TomasD-git/Smart-watch/production/LCSC_BOM.xls

bom.csv |  |  |  |  |  |  |  |  |  | LCSC BOM Quotation
 |  |  |  |  |  |  |  |  |  | BOM Date Created：30/08/26 02:53:16 |  |  |  | BOM Export Date: 30/08/26 02:58:51 |  |  |  | The matching result is a real-time query result, availability and prices may fluctuate. Backorder items are estimated prices for your reference, please submit "Create Quote" to get the real price. All information is provided "as is" and is subject to change without notice. Any use made of the information provided is without recourse to LCSC and at the user's risk.
 |  |  |  |  |  |  |  |  |  | EST TOTAL :$44.15 |  |  |  | Website：https://www.lcsc.com/bom | https://www.lcsc.com/bom | https://www.lcsc.com/bom | https://www.lcsc.com/bom
Uploaded data |  |  |  |  |  |  |  |  |  | LCSC Matching Results
LCSC# | Mfr. | Mrf# | Description | Package | Value | Customer Part Number | Quantity | Target Price(USD) | Target Lead Time(Business Days) | Mrf# | Mfr. | Order Qty. | Unit Price(USD) | Ext.Price(USD) | LCSC# | Package | Min | Mult | SPQ | Availability | Stock Status | Customer Notes | Description | Matched status | Product Link
 |  |  |  |  |  | - | 2 |  |  | - | - | - | - | - | - | - | - | - | - | - | - |  | - | No Matches Found | https://uat.lcsc.com/product-detail/schottky-barrier-diodes-sbd_lge-10mq040n_C688893.html
C89334 |  |  | 2450AT18A100E | ANT-SMD_L3.2-W1.6 |  | - | 1 |  |  | 2450AT18A100E | Johanson Dielectrics | 1 | 1.0289 | 1.03 | C89334 | 1206 | 1 | 1 | 3000 | 7205 | In Stock |  | RF ANTENNA 2.4G Surface Mount 1206 | Exact Matches | https://www.lcsc.com/product-detail/C89334.html
C60474 |  |  | 100nF | 402 |  | - | 100 |  |  | CC0402KRX7R7BB104 | YAGEO | 100 | 0.0054 | 0.54 | C60474 | 0402 | 100 | 100 | 10000 | 11937500 | In Stock |  | 100nF ±10% 16V Ceramic Capacitor X7R 0402 | Exact Matches | https://www.lcsc.com/product-detail/C60474.html
C52923 |  |  | 1uF | 402 |  | - | 50 |  |  | CL05A105KA5NQNC | Samsung Electro-Mechanics | 50 | 0.0122 | 0.61 | C52923 | 0402 | 50 | 50 | 10000 | 3301650 | In Stock |  | 1uF ±10% 25V Ceramic Capacitor X5R 0402 | Exact Matches | https://www.lcsc.com/product-detail/C52923.html
C309455 |  |  | 1pF | 402 |  | - | 100 |  |  | CC0402BRNPO9BN1R0 | YAGEO | 100 | 0.0061 | 0.61 | C309455 | 0402 | 100 | 100 | 10000 | 1296500 | In Stock |  | 1pF 50V Ceramic Capacitor NP0 0402 | Exact Matches | https://www.lcsc.com/product-detail/C309455.html
C76899 |  |  | 1.2pF | 402 |  | - | 20 |  |  | GJM1555C1H1R2WB01D | muRata | 20 | 0.0451 | 0.90 | C76899 | 0402 | 20 | 20 | 10000 | 214240 | In Stock |  | 1.2pF 50V Ceramic Capacitor C0G 0402 | Exact Matches | https://www.lcsc.com/product-detail/C76899.html
C19702 |  |  | 10uF | 603 |  | - | 20 |  |  | CL10A106KP8NNNC | Samsung Electro-Mechanics | 20 | 0.0353 | 0.71 | C19702 | 0603 | 20 | 20 | 4000 | 6626660 | In Stock |  | 10uF ±10% 10V Ceramic Capacitor X5R 0603 | Exact Matches | https://www.lcsc.com/product-detail/C19702.html
C272875 |  |  | 47nF | 402 |  | - | 100 |  |  | CC0402KRX7R9BB473 | YAGEO | 100 | 0.0041 | 0.41 | C272875 | 0402 | 100 | 100 | 10000 | 977700 | In Stock |  | 47nF ±10% 50V Ceramic Capacitor X7R 0402 | Exact Matches | https://www.lcsc.com/product-detail/C272875.html
C368809 |  |  | 4.7uF | 402 |  | - | 50 |  |  | CL05A475KP5NRNC | Samsung Electro-Mechanics | 50 | 0.0187 | 0.94 | C368809 | 0402 | 50 | 50 | 10000 | 1266750 | In Stock |  | 4.7uF ±10% 10V Ceramic Capacitor X5R 0402 | Exact Matches | https://www.lcsc.com/product-detail/C368809.html
C19666 |  |  | 4.7uF | 603 |  | - | 10 |  |  | CL10A475KO8NNNC | Samsung Electro-Mechanics | 10 | 0.0337 | 0.34 | C19666 | 0603 | 10 | 10 | 4000 | 1965340 | In Stock |  | 4.7uF ±10% 16V Ceramic Capacitor X5R 0603 | Exact Matches | https://www.lcsc.com/product-detail/C19666.html
C106202 |  |  | 18pF | 402 |  | - | 100 |  |  | CC0402JRNPO9BN180 | YAGEO | 100 | 0.0062 | 0.62 | C106202 | 0402 | 100 | 100 | 10000 | 1159600 | In Stock |  | 18pF ±5% 50V Ceramic Capacitor NP0 0402 | Exact Matches | https://www.lcsc.com/product-detail/C106202.html
C106201 |  |  | 12pF | 402 |  | - | 100 |  |  | CC0402JRNPO9BN120 | YAGEO | 100 | 0.0038 | 0.38 | C106201 | 0402 | 100 | 100 | 10000 | 2052800 | In Stock |  | 12pF ±5% 50V Ceramic Capacitor NP0 0402 | Exact Matches | https://www.lcsc.com/product-detail/C106201.html
C77177 |  |  | 100pF | 402 |  | - | 50 |  |  | GRM1555C1H101JA01D | muRata | 50 | 0.0109 | 0.55 | C77177 | 0402 | 50 | 50 | 10000 | 974400 | In Stock |  | 100pF ±5% 50V Ceramic Capacitor C0G 0402 | Exact Matches | https://www.lcsc.com/product-detail/C77177.html
C107031 |  |  | 820pF | 402 |  | - | 100 |  |  | CC0402KRX7R9BB821 | YAGEO | 100 | 0.0067 | 0.67 | C107031 | 0402 | 100 | 100 | 10000 | 318400 | In Stock |  | 820pF ±10% 50V Ceramic Capacitor X7R 0402 | Exact Matches | https://www.lcsc.com/product-detail/C107031.html
C82046 |  |  | MBR0530T1G | SOD-123_L2.7-W1.6-LS3.7-RD-1 |  | - | 10 |  |  | MBR0530T1G | onsemi | 10 | 0.0685 | 0.69 | C82046 | SOD-123 | 10 | 10 | 3000 | 94330 | In Stock |  | Diode 30V 500mA Surface Mount SOD-123 | Exact Matches | https://www.lcsc.com/product-detail/C82046.html
C262643 |  |  | AFC07-S24ECA-00 | FPC-SMD_AFC07-S24ECA-00 |  | - | 5 |  |  | AFC07-S24ECA-00 | JUSHUO | 5 | 0.1327 | 0.66 | C262643 | SMD,P=0.5mm,Surface Mount,Right Angle | 5 | 5 | 2000 | 45965 | In Stock |  | FFC/FPC Connector 24 Position 0.5mm Pitch Top Contact Surface Mount, Right Angle | Exact Matches | https://www.lcsc.com/product-detail/C262643.html
 |  |  | Conn_01x03 | PinHeader_1x03_P2.54mm_Vertical |  | - | 1 |  |  | - | - | - | - | - | - | - | - | - | - | - | - |  | - | No Matches Found
 |  |  | Conn_01x05 | PinHeader_1x05_P2.54mm_Vertical |  | - | 1 |  |  | - | - | - | - | - | - | - | - | - | - | - | - |  | - | No Matches Found
C88173 |  |  | 10uH | 805 |  | - | 10 |  |  | MLZ2012M100WT000 | TDK | 10 | 0.0629 | 0.63 | C88173 | 0805 | 10 | 10 | 2000 | 76070 | In Stock |  | 350mA 10uH ±20% 150mA 470mΩ Multilayer inductor 0805 Fixed Inductors RoHS | Exact Matches | https://www.lcsc.com/product-detail/C88173.html
C383402 |  |  | 15uH | 805 |  | - | 10 |  |  | MLZ2012M150WT000 | TDK | 10 | 0.0631 | 0.63 | C383402 | 0805 | 10 | 10 | 2000 | 34820 | In Stock |  | 250mA 15uH ±20% 120mA 950mΩ Multilayer inductor 0805 Fixed Inductors RoHS | Exact Matches | https://www.lcsc.com/product-detail/C383402.html
C86065 |  |  | 4.7nH | 402 |  | - | 100 |  |  | LQG15HS4N7S02D | muRata | 100 | 0.0155 | 1.55 | C86065 | 0402 | 100 | 100 | 10000 | 181500 | In Stock |  | 700mA 4.7nH 160mΩ Multilayer inductor 0402 Fixed Inductors RoHS | Exact Matches | https://www.lcsc.com/product-detail/C86065.html
C86061 |  |  | 2.2nH | 402 |  | - | 50 |  |  | LQG15HS2N2S02D | muRata | 50 | 0.0185 | 0.93 | C86061 | 0402 | 50 | 50 | 10000 | 36250 | In Stock |  | 900mA 2.2nH 120mΩ Multilayer inductor 0402 Fixed Inductors RoHS | Exact Matches | https://www.lcsc.com/product-detail/C86061.html
C524993 |  |  | BRL3225T470K | IND-SMD_L3.2-W2.5-BRL3225T100M |  | - | 5 |  |  | BRL3225T470K | Taiyo Yuden | 5 | 0.1333 | 0.67 | C524993 | 1210 | 5 | 5 | 2000 | 4425 | In Stock |  | 390mA 47uH ±10% 420mA 1.2Ω 1210 Fixed Inductors RoHS | Exact Matches | https://www.lcsc.com/product-detail/C524993.html
C77108 |  |  | 2.7nH | 402 |  | - | 50 |  |  | LQG15HS2N7S02D | muRata | 50 | 0.0221 | 1.11 | C77108 | 0402 | 50 | 50 | 10000 | 182600 | In Stock |  | 800mA 2.7nH 150mΩ Multilayer inductor 0402 Fixed Inductors RoHS | Exact Matches | https://www.lcsc.com/product-detail/C77108.html
C77109 |  |  | 3.9nH | 402 |  | - | 50 |  |  | LQG15HS3N9S02D | muRata | 50 | 0.0177 | 0.89 | C77109 | 0402 | 50 | 50 | 10000 | 100350 | In Stock |  | 750mA 3.9nH 180mΩ Multilayer inductor 0402 Fixed Inductors RoHS | Exact Matches | https://www.lcsc.com/product-detail/C77109.html
C347475 |  |  | AO3400A_C347475 | SOT-23-3_L2.9-W1.3-P1.90-LS2.4-BR |  | - | 20 |  |  | AO3400A | UMW | 20 | 0.0372 | 0.74 | C347475 | SOT-23 | 20 | 20 | 3000 | 1220380 | In Stock |  | N-Channel 30V 5.8A 1.4W Surface Mount SOT-23 | Exact Matches | https://www.lcsc.com/product-detail/C347475.html
C25803 |  |  | 100k | 603 |  | - | 100 |  |  | 0603WAF1003T5E | UNI-ROYAL | 100 | 0.0042 | 0.42 | C25803 | 0603 | 100 | 100 | 5000 | 15234400 | In Stock |  | 100kΩ ±1% 100mW 0603 Thick Film Resistor | Exact Matches | https://www.lcsc.com/product-detail/C25803.html
C98220 |  |  | 10k | 603 |  | - | 100 |  |  | RC0603FR-0710KL | YAGEO | 100 | 0.0040 | 0.40 | C98220 | 0603 | 100 | 100 | 5000 | 11908900 | In Stock |  | 100mW 10kΩ 75V Thick Film Resistor ±100ppm/℃ ±1% 0603 Chip Resistor - Surface Mount RoHS | Exact Matches | https://www.lcsc.com/product-detail/C98220.html
C2907044 |  |  | 5.1k | 603 |  | - | 100 |  |  | FRC0603F5101TS | FOJAN | 100 | 0.0021 | 0.21 | C2907044 | 0603 | 100 | 100 | 5000 | 7175900 | In Stock |  | 5.1kΩ ±1% 100mW 0603 Thick Film Resistor | Exact Matches | https://www.lcsc.com/product-detail/C2907044.html
C2907166 |  |  | 4.7k | 603 |  | - | 100 |  |  | FRC0603J472 TS | FOJAN | 100 | 0.0022 | 0.22 | C2907166 | 0603 | 100 | 100 | 5000 | 8569000 | In Stock |  | 4.7kΩ ±5% 100mW 0603 Thick Film Resistor | Exact Matches | https://www.lcsc.com/product-detail/C2907166.html
C2907005 |  |  | 2.2k | 603 |  | - | 100 |  |  | FRC0603F2201TS | FOJAN | 100 | 0.0022 | 0.22 | C2907005 | 0603 | 100 | 100 | 5000 | 5079800 | In Stock |  | 2.2kΩ ±1% 100mW 0603 Thick Film Resistor | Exact Matches | https://www.lcsc.com/product-detail/C2907005.html
C2930150 |  |  | 3 | 603 |  | - | 100 |  |  | FRC0603F3R00TS | FOJAN | 100 | 0.0028 | 0.28 | C2930150 | 0603 | 100 | 100 | 5000 | 125500 | In Stock |  | 3Ω ±1% 100mW 0603 Thick Film Resistor | Exact Matches | https://www.lcsc.com/product-detail/C2930150.html
C2907003 |  |  | FRC0603F1004TS | R0603 |  | - | 100 |  |  | FRC0603F1004TS | FOJAN | 100 | 0.0023 | 0.23 | C2907003 | 0603 | 100 | 100 | 5000 | 6053400 | In Stock |  | 1MΩ ±1% 100mW 0603 Thick Film Resistor | Exact Matches | https://www.lcsc.com/product-detail/C2907003.html
C2906983 |  |  | 10 | 603 |  | - | 100 |  |  | FRC0603F10R0TS | FOJAN | 100 | 0.0025 | 0.25 | C2906983 | 0603 | 100 | 100 | 5000 | 3802200 | In Stock |  | 10Ω ±1% 100mW 0603 Thick Film Resistor | Exact Matches | https://www.lcsc.com/product-detail/C2906983.html
C42420265 |  |  | TS-24CA-S26 | SW-SMD_L4.7-W3.5-P3.35-EH |  | - | 10 |  |  | TS-24CA-S26 | JXTCONN | 10 | 0.0247 | 0.25 | C42420265 | SMD-4P,4.8x2.1mm | 10 | 10 | 3000 | 31070 | In Stock |  | Tactile Switch SPST 260gf SMD (SMT) Tab Surface Mount, Right Angle | Exact Matches | https://www.lcsc.com/product-detail/C42420265.html
C44639442 |  |  | BQ25186DLHR | WSON-10_L2.2-W2.0-P0.40-BL-EP_TI_DLH0010A |  | - | 1 |  |  | BQ25186DLHR | TI | 1 | 2.3108 | 2.31 | C44639442 | WSON-10 | 1 | 1 | 3000 | 1520 | Backordered |  | 3.6V~18V 1 1A WSON-10 Battery Chargers RoHS | Exact Matches | https://www.lcsc.com/product-detail/C44639442.html
C2836813 |  |  | BMI270 | LGA-14_L3.0-W2.5-P0.50-BR |  | - | 1 |  |  | BMI270 | Bosch | 1 | 3.2183 | 3.22 | C2836813 | LGA-14(2.5x3) | 1 | 1 | 5000 | 9433 | In Stock |  | LGA-14(2.5x3) IMUs (Inertial Measurement Units) RoHS | Exact Matches | https://www.lcsc.com/product-detail/C2836813.html
C171681 |  |  | BMM150 | WLCSP-12_L1.6-W1.6_BMM150 |  | - | 1 |  |  | BMM150 | Bosch | 0 | 0.7593 | 0.01 | C171681 | - | 1 | 1 | 10000 | 5402 | In Stock |  | WLCSP-12(1.6x1.6) Linear, Compass (ICs) RoHS | Exact Matches
C3019759 |  |  | RV-3028-C7 32.768KHZ 1PPM TA QC | OSC-SMD_8P-L3.2-W1.5-P0.90-BL |  | - | 1 |  |  | RV-3028-C7-32.768kHz-1ppm-TA-QC | Micro Crystal | 1 | 2.2239 | 2.22 | C3019759 | SMD3215-8P | 1 | 1 | 1000 | 1250 | Backordered |  | Built-in Yes SMD3215-8P Real Time Clocks RoHS | Exact Matches | https://www.lcsc.com/product-detail/C3019759.html
C190794 |  |  | NRF52840-QIAA-R | AQFN-73_L7.0-W7.0-P0.50-BL-EP4.8 |  | - | 1 |  |  | NRF52840-QIAA-R | NORDIC | 1 | 5.8937 | 5.89 | C190794 | AQFN-73-EP(7x7) | 1 | 1 | 3000 | 52163 | In Stock |  | IC RF TXRX Bluetooth ISM IoT LoRa ZigBee 2400MHz~2483.5MHz AQFN-73-EP(7x7) | Exact Matches | https://www.lcsc.com/product-detail/C190794.html
C2682616 |  |  | MAX17048G+T10 | TDFN-8_L2.0-W2.0-P0.50-BL-EP1.2 |  | - | 1 |  |  | MAX17048G+T10 | MAXIM | 1 | 2.1864 | 2.19 | C2682616 | DFN-8-EP(2x2) | 1 | 1 | 10000 | 15395 | In Stock |  | I2C Lithium Battery DFN-8-EP(2x2) Battery Management RoHS | Exact Matches | https://www.lcsc.com/product-detail/C2682616.html
C50275770 |  |  | MD-LRA371-H20 | MIC-SMD_6P-L3.0-W2.3_MD-LRA371-H20 |  | - | 1 |  |  | MD-LRA371-H20 | Gettop | 1 | 0.7680 | 0.77 | C50275770 | SMD | 1 | 1 | 5500 | 5213 | In Stock |  | Omnidirectional -37dB 65dB SMD Microphones | Exact Matches | https://www.lcsc.com/product-detail/C50275770.html
C97522 |  |  | W25Q256JVEIQTR | WSON-8_L8.0-W6.10-P1.27-BL-EP |  | - | 1 |  |  | W25Q256JVEIQ | Winbond | 1 | 4.5589 | 4.56 | C97522 | WSON-8-EP(6x8) | 1 | 1 | 4000 | 12599 | In Stock |  | FLASH - NOR Memory IC 256Mbit SPI 133MHz WSON-8-EP(6x8) | Exact Matches | https://www.lcsc.com/product-detail/C97522.html
C2765186 |  |  | TYPE-C 16PIN 2MD | USB-C-SMD_TYPE-C-16PIN-2MD-073 |  | - | 20 |  |  | TYPE-C 16PIN 2MD(073) | SHOU HAN | 20 | 0.0707 | 1.41 | C2765186 | SMD | 20 | 20 | 1000 | 985460 | In Stock |  | USB-C (USB TYPE-C) Receptacle Connector 16 Position Surface Mount, Right Angle | Exact Matches | https://www.lcsc.com/product-detail/C2765186.html
C2842180 |  |  | FC31M2-32.768-NTLLLDT | CRYSTAL-SMD_L3.2-W1.5-1 |  | - | 5 |  |  | FC31M2-32.768-NTLLLDT | HCI | 5 | 0.2029 | 1.01 | C2842180 | SMD3215-2P | 5 | 5 | 3000 | 5585 | In Stock |  | Crystal 32.768kHz ±20ppm 12.5pF 50kΩ SMD3215-2P | Exact Matches | https://www.lcsc.com/product-detail/C2842180.html
C187794 |  |  | Q22FA12800025 | CRYSTAL-SMD_4P-L2.0-W1.6-BL |  | - | 5 |  |  | Q22FA12800025 | EPSON | 5 | 0.2546 | 1.27 | C187794 | SMD2016-4P | 5 | 5 | 3000 | 11530 | In Stock |  | Crystal 32MHz ±10ppm 8pF 60Ω SMD2016-4P | Exact Matches | https://www.lcsc.com/product-detail/C187794.html
