TomasD-git/Smart-watch/CAD/250mah 3.7V battery.stp

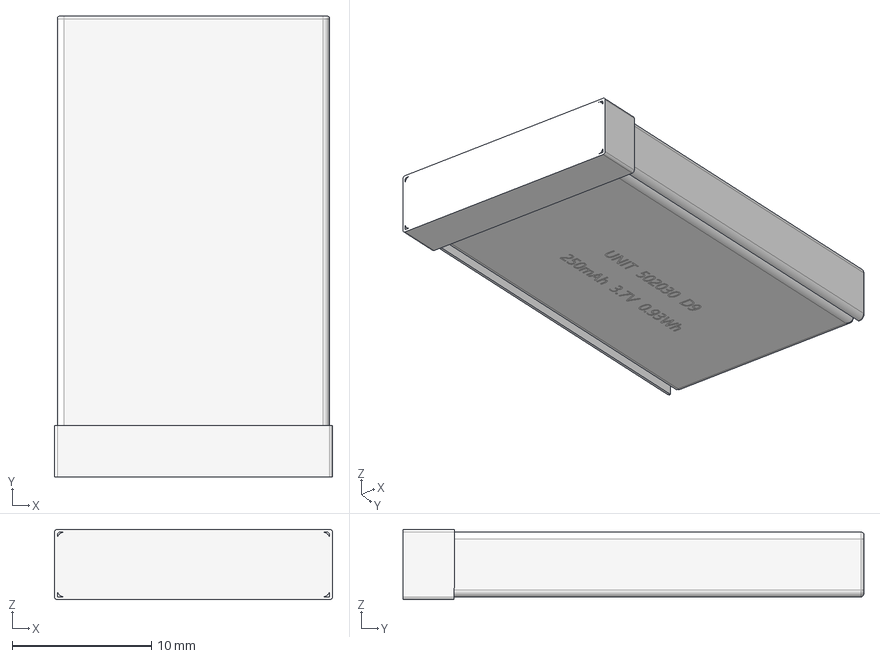
[picture p1: CAD file, 2026-09-03]
CAD/250mah 3.7V battery.stp
20.0 x 33.1 x 5.05 mm
