TomasD-git/Smart-watch/CAD/Smart watch PCB.step

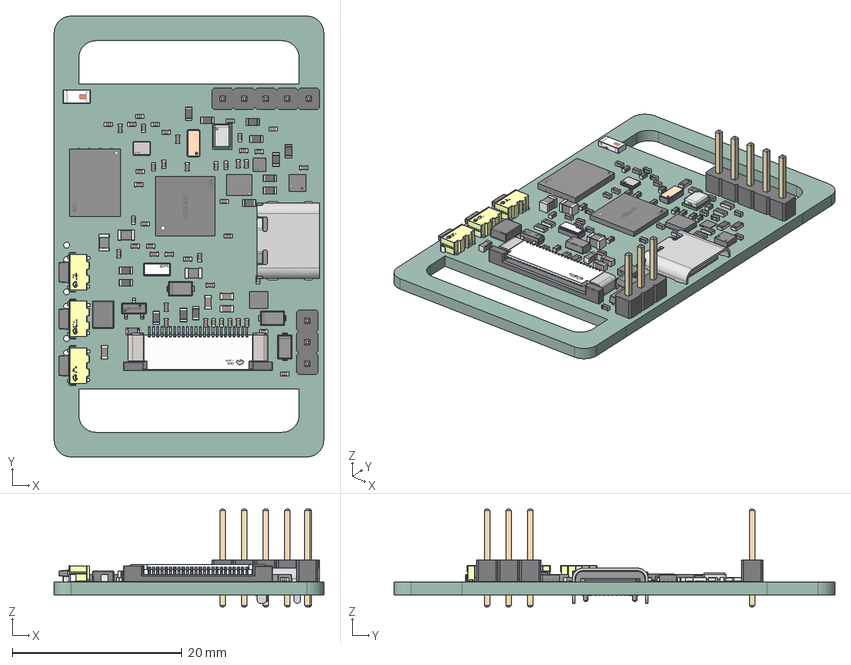
[picture p2: CAD file, 2026-09-03]
CAD/Smart watch PCB.step
31.8 x 52.0 x 11.5 mm
R0603
C_0603_1608Metric x 4
C_0402_1005Metric x 42
R_0603_1608Metric x 14
SOT-23-3P_L2.9-W1.3-H1.0-LS2.4-P0.95
IND-SMD_L3.2-W2.5-BRL3225T100M
L_0805_2012Metric x 3
L_0402_1005Metric x 4
OSC-SMD_8P-L3.2-W1.5-P0.90-BL
CRYSTAL-SMD_4P-L2.0-W1.6-BL
WSON-8_L8.0-W6.0-H0.78-P1.27
SW-SMD_L4.7-W3.5-H1.9-P3.35-EH x 3
PinHeader_1x05_P2.54mm_Vertical
CRYSTAL-SMD_L3.2-W1.5-1
AQFN-73_L7.0-W7.0-H0.9-P0.50
WSON-10_L2.2-W2.0-P0.40-BL-EP_TI_DLH0010A
USB-C-SMD_TYPE-C-6PIN-2MD-073
SOD-123_L2.7-W1.6-LS3.7-RD-1 x 3
TDFN-8_L2.0-W2.0-P0.50-BL-EP1.2
FPC-SMD_AFC07-S24ECA-00
MIC-SMD_6P-L3.0-W2.3_MD-LRA371-H20
WLCSP-12_L1.6-W1.6-H0.6_BMM150
PinHeader_1x03_P2.54mm_Vertical
LGA-14_L3.0-W2.5-P0.50-BR
ANT-SMD_L3.2-W1.6-H1.3
Smart watch_PCB
