TomasD-git/Smart-watch/CAD/1.54 in e-paper 200x200 GDEY0154D67.step

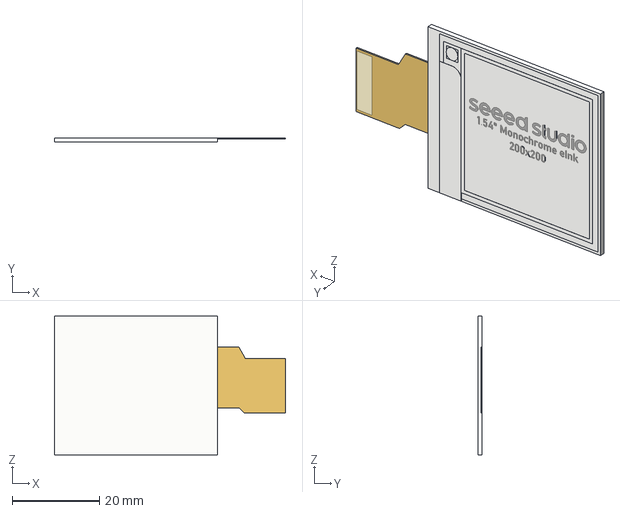
[picture p3: CAD file, 2026-09-03]
CAD/1.54 in e-paper 200x200 GDEY0154D67.step
52.9 x 1.00 x 31.8 mm
