TomasD-git/Smart-watch/CAD/Smart watch NFC Coil PCB.step

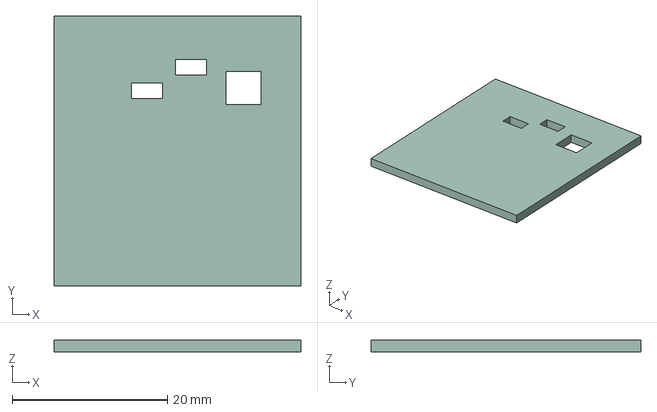
[picture p4: CAD file, 2026-09-03]
CAD/Smart watch NFC Coil PCB.step
31.8 x 34.8 x 1.51 mm
