TomasD-git/Smart-watch/CAD/Top.step

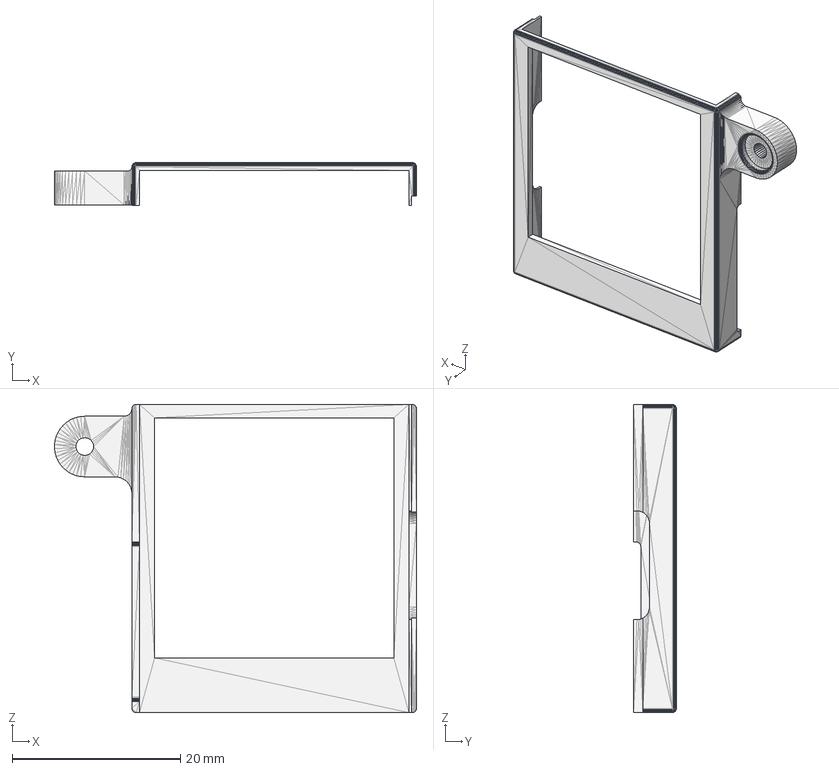
[picture p6: CAD file, 2026-09-03]
CAD/Top.step
43.0 x 5.10 x 36.6 mm
