TomasD-git/Smart-watch/CAD/Bottom.step

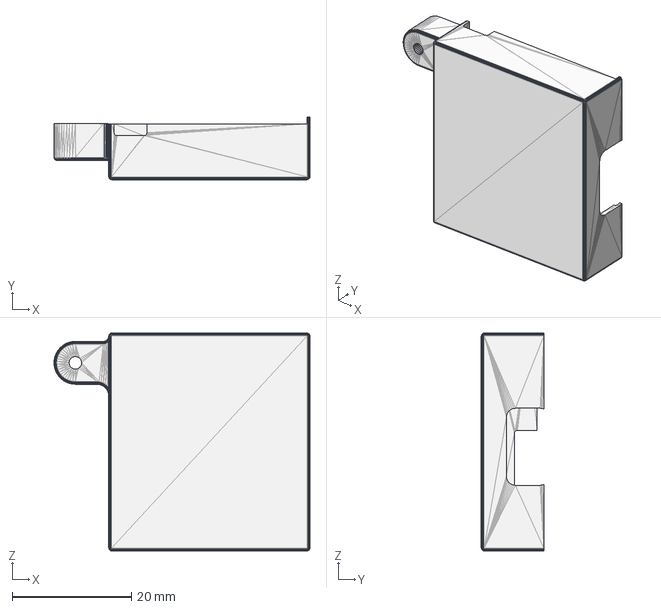
[picture p7: CAD file, 2026-09-03]
CAD/Bottom.step
43.0 x 10.5 x 36.6 mm
