TomasD-git/Smart-watch/(list of files, cad)

Other CAD files:
CAD/Smart Watch source CAD.f3z
