TomasD-git/Smart-watch/Smart Watch/Smart watch/Smart watch.kicad_pcb

## KiCad design Smart Watch/Smart watch/Smart watch.kicad_pcb (2026-09-03)

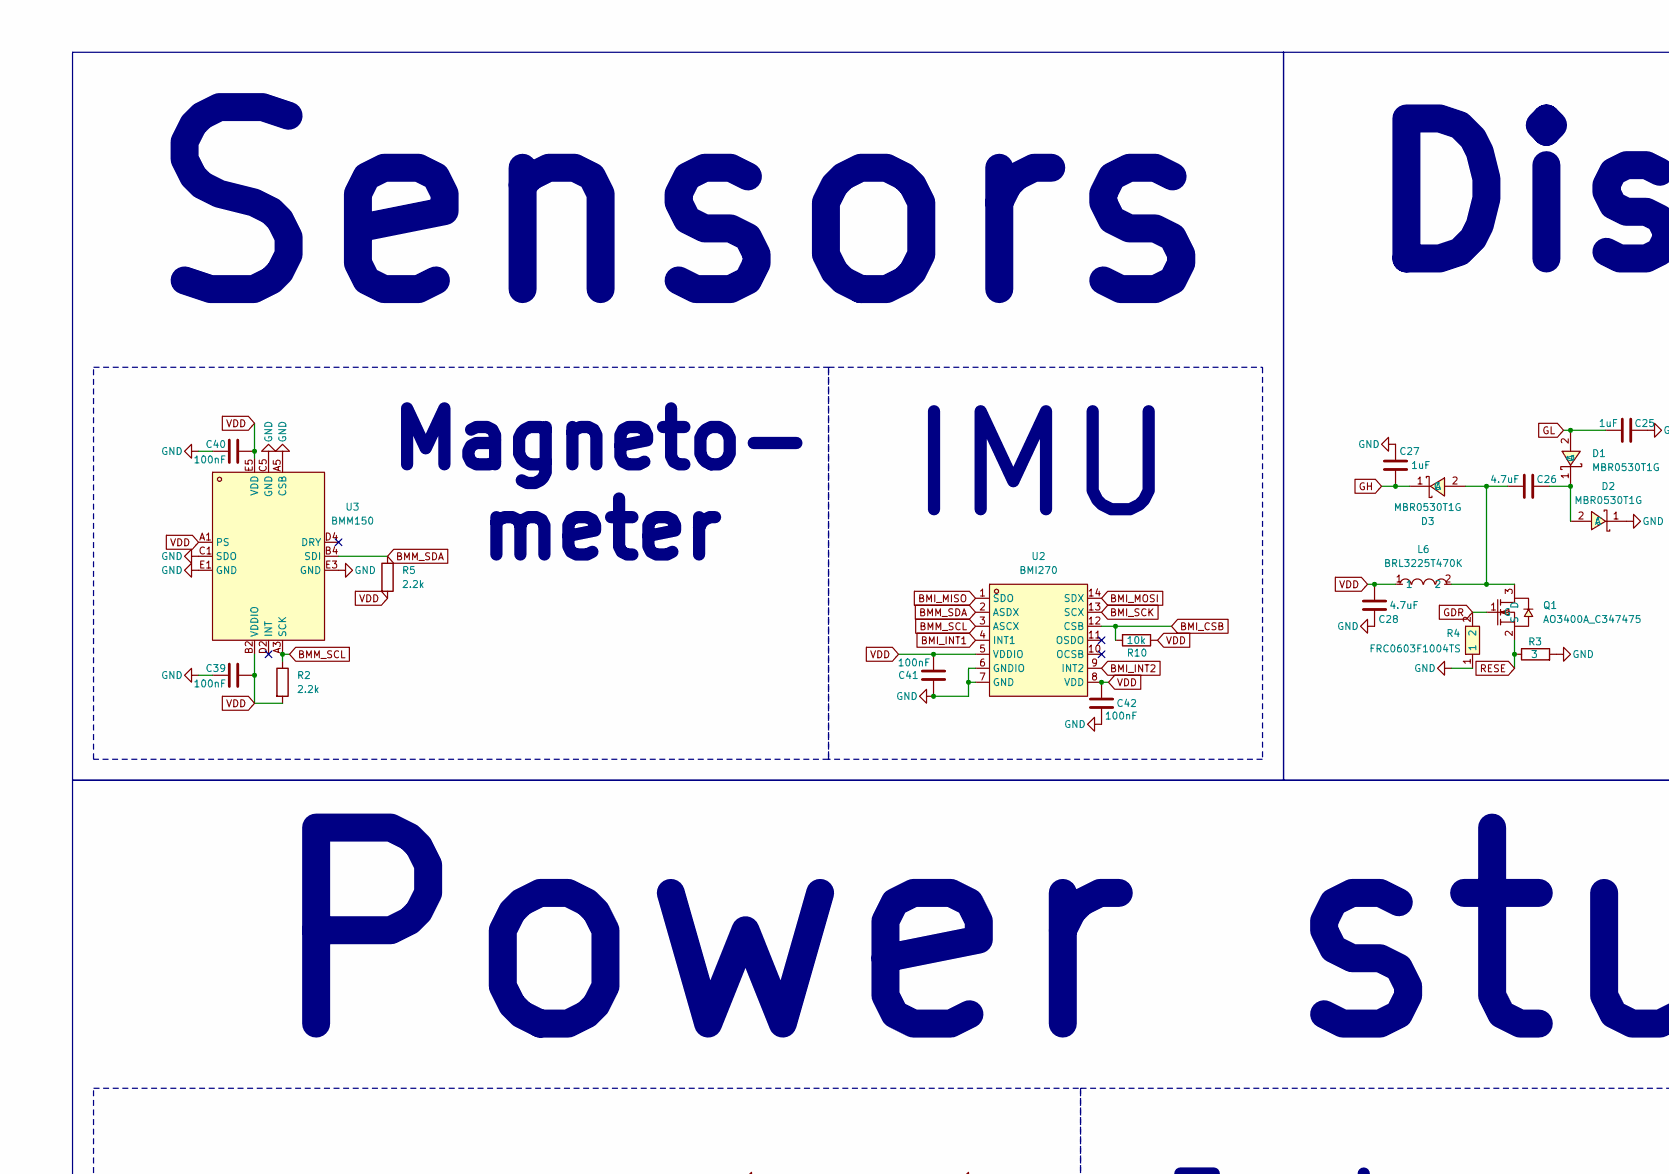
[picture p8: schematic Smart watch.kicad_sch, part in row 1, column 1]

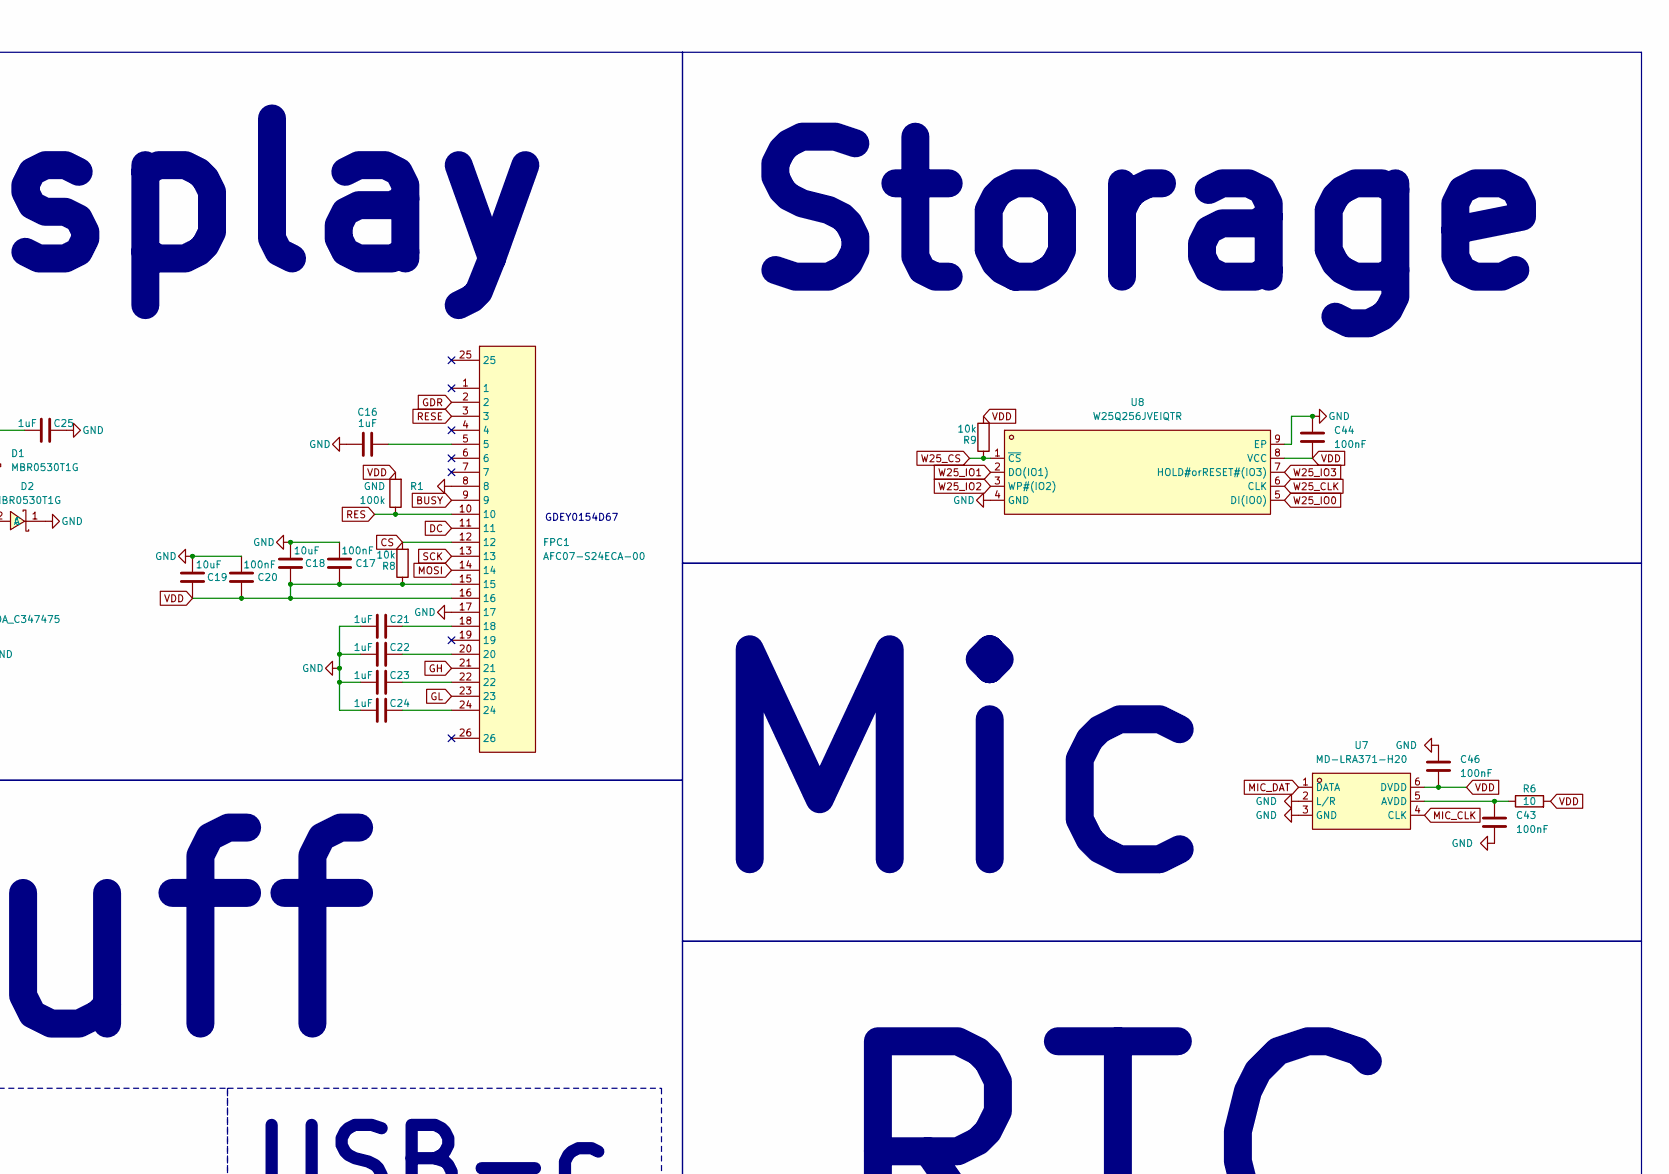
[picture p9: schematic Smart watch.kicad_sch, part in row 1, column 2]

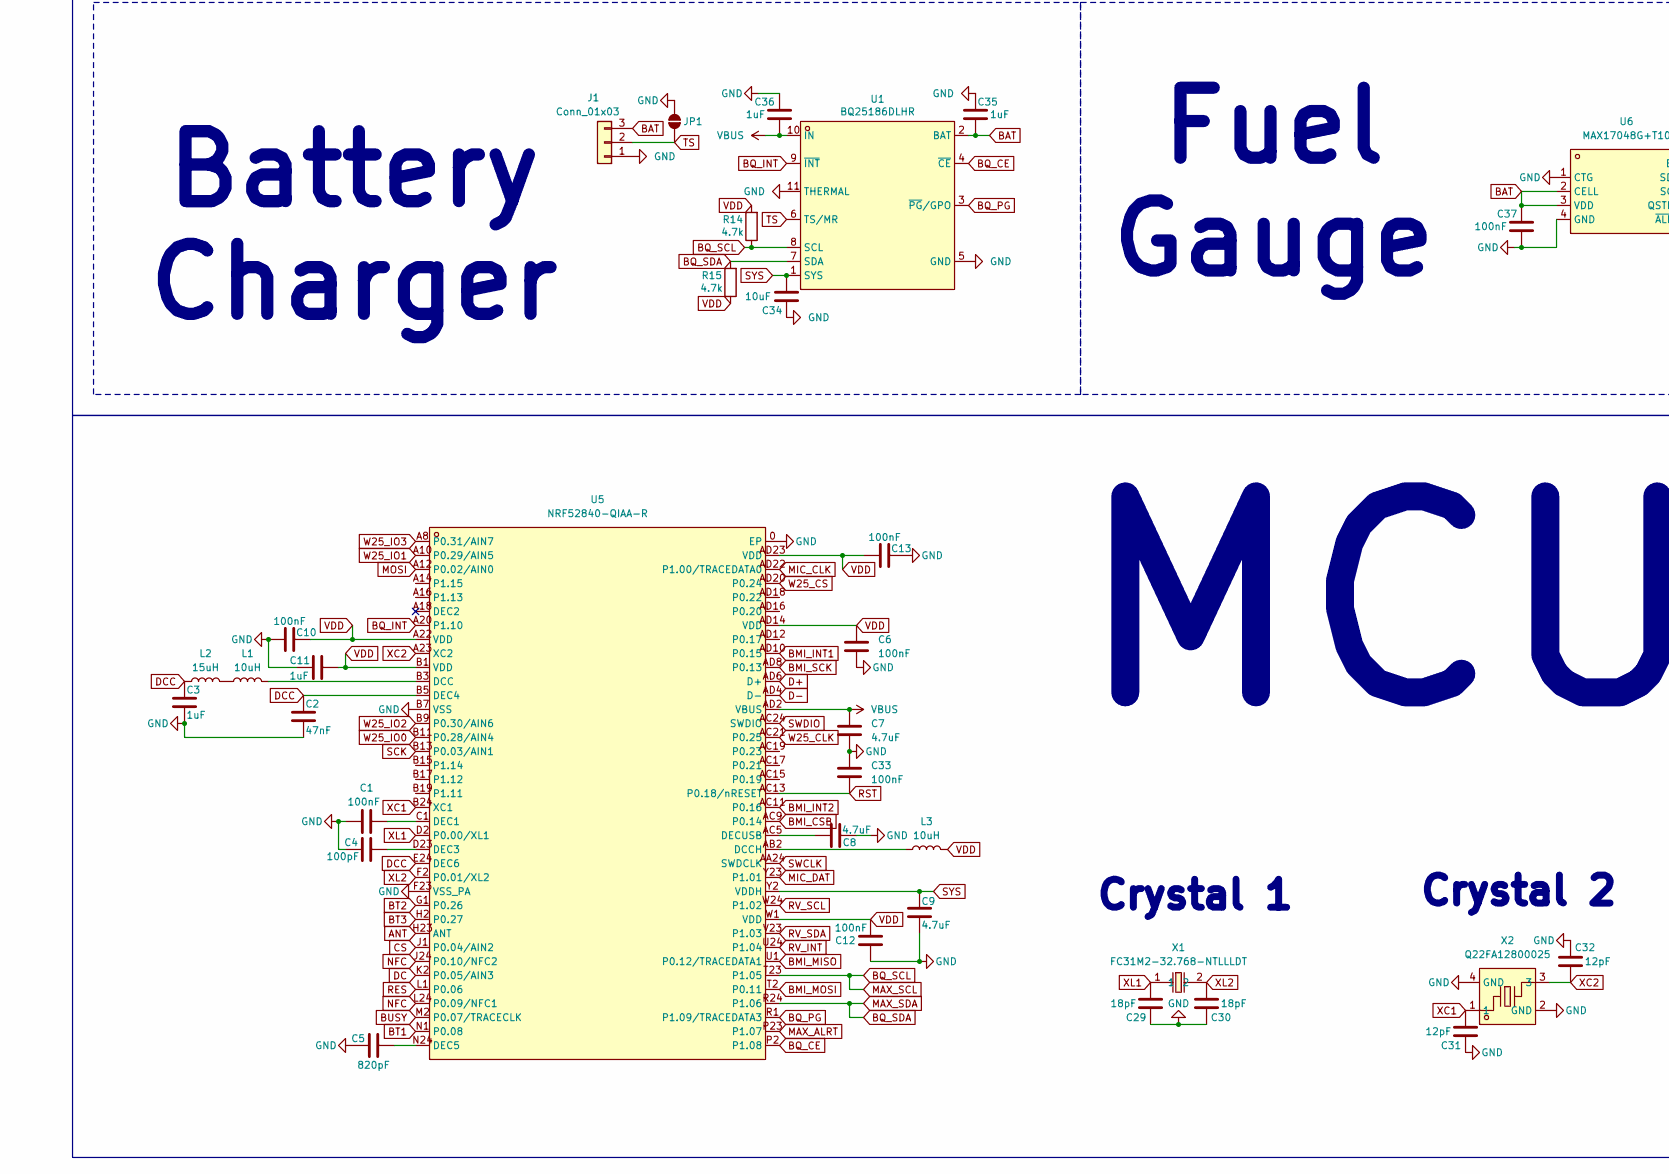
[picture p10: schematic Smart watch.kicad_sch, part in row 2, column 1]

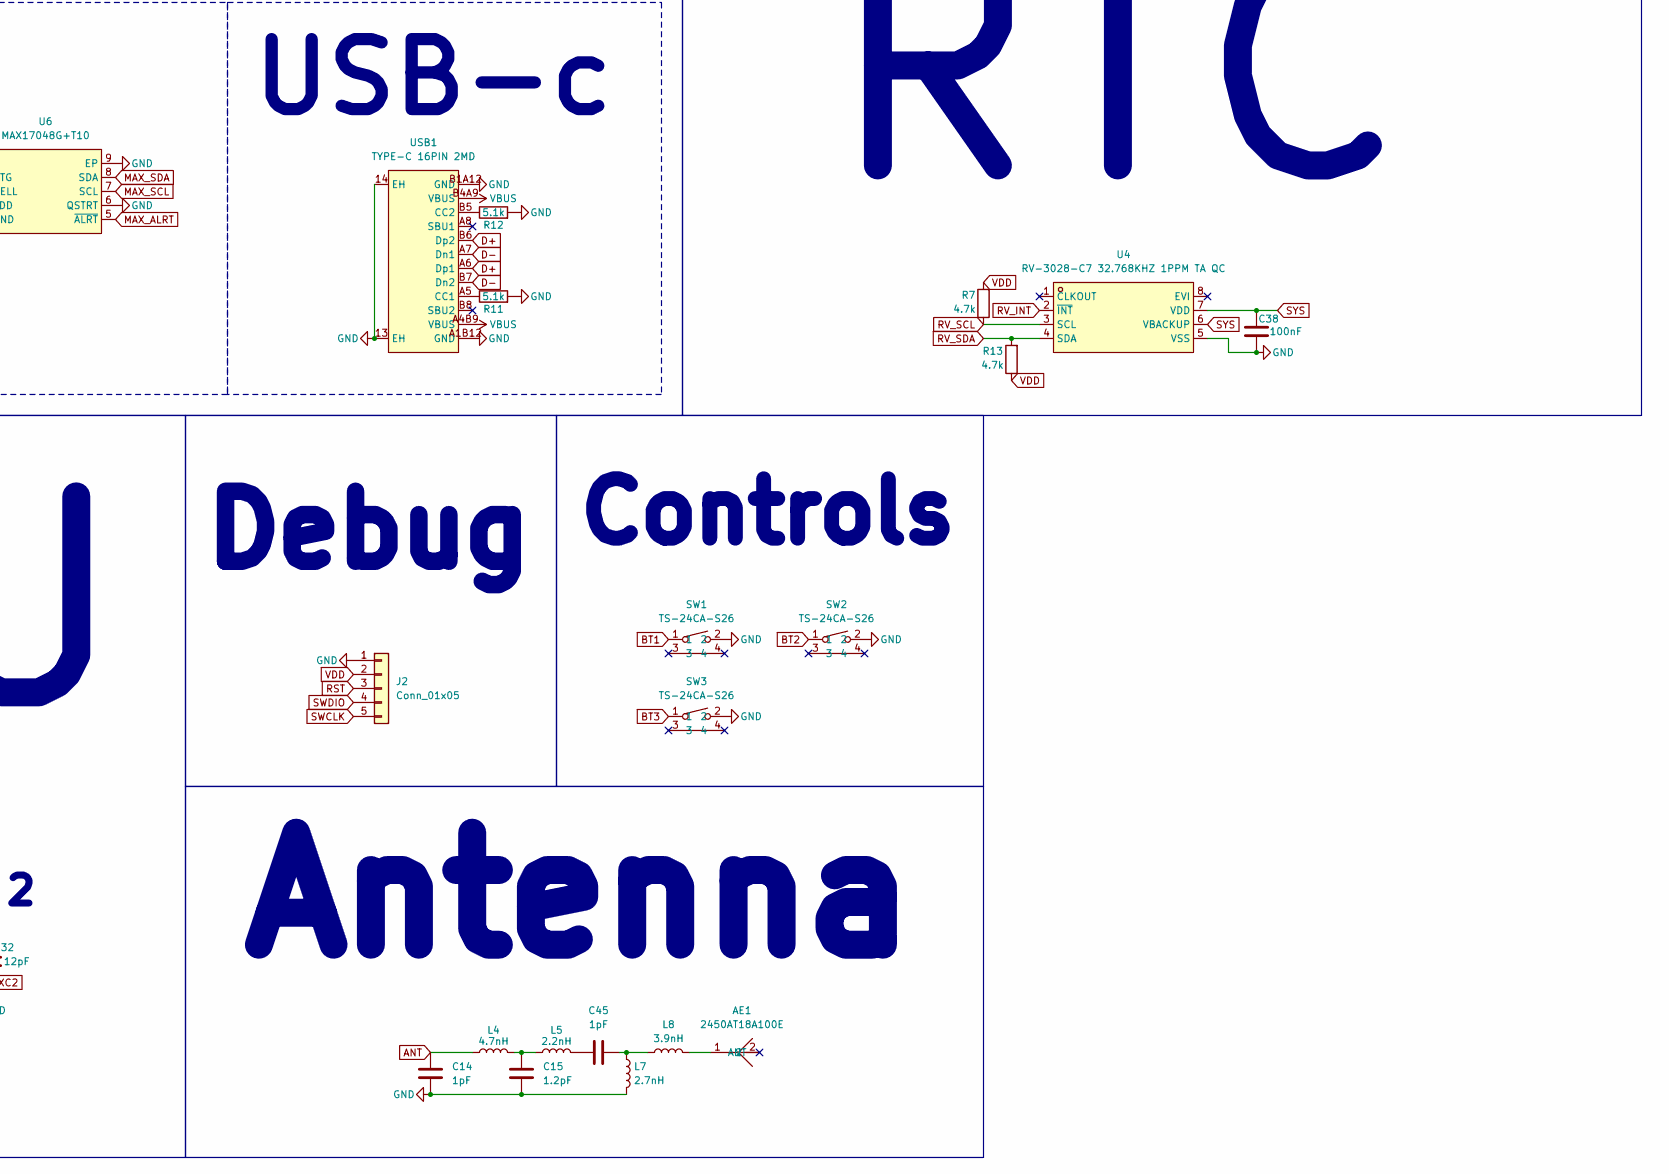
[picture p11: schematic Smart watch.kicad_sch, part in row 2, column 2]

Parts:
AE1: 2450AT18A100E; ANT-SMD_L3.2-W1.6; MPN 2450AT18A100E; LCSC Part C89334
C1, C6, C10, C12, C13, C17, C20, C33, C37, C38, C39, C40, C41, C42, C43, C44, C46: 100nF; C_0402_1005Metric
C2: 47nF; C_0402_1005Metric
C3, C11, C16, C21, C22, C23, C24, C25, C27, C35, C36: 1uF; C_0402_1005Metric
C4: 100pF; C_0402_1005Metric
C5: 820pF; C_0402_1005Metric
C7, C8, C9, C26: 4.7uF; C_0402_1005Metric
C14, C45: 1pF; C_0402_1005Metric
C15: 1.2pF; C_0402_1005Metric
C18, C19, C34: 10uF; C_0603_1608Metric
C28: 4.7uF; C_0603_1608Metric
C29, C30: 18pF; C_0402_1005Metric
C31, C32: 12pF; C_0402_1005Metric
D1, D2, D3: MBR0530T1G; SOD-123_L2.7-W1.6-LS3.7-RD-1; MPN MBR0530T1G; LCSC Part C82046
FPC1: AFC07-S24ECA-00; FPC-SMD_AFC07-S24ECA-00; MPN AFC07-S24ECA-00; LCSC Part C262643
J1: Conn_01x03; PinHeader_1x03_P2.54mm_Vertical
J2: Conn_01x05; PinHeader_1x05_P2.54mm_Vertical
JP1: SolderJumper_2_Open; SolderJumper-2_P1.3mm_Open_RoundedPad1.0x1.5mm
L1, L3: 10uH; L_0805_2012Metric
L2: 15uH; L_0805_2012Metric
L4: 4.7nH; L_0402_1005Metric
L5: 2.2nH; L_0402_1005Metric
L6: BRL3225T470K; IND-SMD_L3.2-W2.5-BRL3225T100M; MPN BRL3225T470K; LCSC Part C524993
L7: 2.7nH; L_0402_1005Metric
L8: 3.9nH; L_0402_1005Metric
Q1: AO3400A_C347475; SOT-23-3_L2.9-W1.3-P1.90-LS2.4-BR; MPN AO3400A; LCSC Part C347475
R1: 100k; R_0603_1608Metric
R2, R5: 2.2k; R_0603_1608Metric
R3: 3; R_0603_1608Metric
R4: FRC0603F1004TS; R0603; MPN FRC0603F1004TS; LCSC Part C2907003
R6: 10; R_0603_1608Metric
R7, R13, R14, R15: 4.7k; R_0603_1608Metric
R8, R9, R10: 10k; R_0603_1608Metric
R11, R12: 5.1k; R_0603_1608Metric
SW1, SW2, SW3: TS-24CA-S26; SW-SMD_L4.7-W3.5-P3.35-EH; MPN TS-24CA-S26; LCSC Part C42420265
U1: BQ25186DLHR; WSON-10_L2.2-W2.0-P0.40-BL-EP_TI_DLH0010A; MPN BQ25186DLHR; LCSC Part C44639442
U2: BMI270; LGA-14_L3.0-W2.5-P0.50-BR; MPN BMI270; LCSC Part C2836813
U3: BMM150; WLCSP-12_L1.6-W1.6_BMM150; MPN BMM150; LCSC Part C171681
U4: RV-3028-C7 32.768KHZ 1PPM TA QC; OSC-SMD_8P-L3.2-W1.5-P0.90-BL; MPN RV-3028-C7-32.768kHz-1ppm-TA-QC; LCSC Part C3019759
U5: NRF52840-QIAA-R; AQFN-73_L7.0-W7.0-P0.50-BL-EP4.8; MPN NRF52840-QIAA-R; LCSC Part C190794
U6: MAX17048G+T10; TDFN-8_L2.0-W2.0-P0.50-BL-EP1.2; MPN MAX17048G+T10; LCSC Part C2682616
U7: MD-LRA371-H20; MIC-SMD_6P-L3.0-W2.3_MD-LRA371-H20; MPN MD-LRA371-H20; LCSC Part C50275770
U8: W25Q256JVEIQTR; WSON-8_L8.0-W6.10-P1.27-BL-EP; MPN W25Q256JVEIQ; LCSC Part C97522
USB1: TYPE-C 16PIN 2MD; USB-C-SMD_TYPE-C-16PIN-2MD-073; MPN TYPE-C 16PIN 2MD(073); LCSC Part C2765186
X1: FC31M2-32.768-NTLLLDT; CRYSTAL-SMD_L3.2-W1.5-1; MPN FC31M2-32.768-NTLLLDT; LCSC Part C2842180
X2: Q22FA12800025; CRYSTAL-SMD_4P-L2.0-W1.6-BL; MPN Q22FA12800025; LCSC Part C187794

Connections:
ANT: C14.1, L4.1, U5.H23 (ANT)
BAT: C35.2, C37.2, J1.3, U1.2 (BAT), U6.2 (CELL), U6.3 (VDD)
BMI_CSB: R10.2, U2.12 (CSB), U5.AC9 (P0.14)
BMI_INT1: U2.4 (INT1), U5.AD10 (P0.15)
BMI_INT2: U2.9 (INT2), U5.AC11 (P0.16)
BMI_MISO: U2.1 (SDO), U5.U1 (P0.12/TRACEDATA1)
BMI_MOSI: U2.14 (SDX), U5.T2 (P0.11)
BMI_SCK: U2.13 (SCX), U5.AD8 (P0.13)
BMM_SCL: R2.1, U2.3 (ASCX), U3.A3 (SCK)
BMM_SDA: R5.1, U2.2 (ASDX), U3.B4 (SDI)
BQ_CE: U1.4 (~CE), U5.P2 (P1.08)
BQ_INT: U1.9 (~INT), U5.A20 (P1.10)
BQ_PG: U1.3 (~PG/GPO), U5.R1 (P1.09/TRACEDATA3)
BQ_SCL: R14.1, U1.8 (SCL), U5.T23 (P1.05), U6.7 (SCL)
BQ_SDA: R15.2, U1.7 (SDA), U5.R24 (P1.06), U6.8 (SDA)
BT1: SW1.1, U5.N1 (P0.08)
BT2: SW2.1, U5.G1 (P0.26)
BT3: SW3.1, U5.H2 (P0.27)
BUSY: FPC1.9, U5.M2 (P0.07/TRACECLK)
CS: FPC1.12, R8.2, U5.J1 (P0.04/AIN2)
D+: U5.AD6 (D+), USB1.A6 (Dp1), USB1.B6 (Dp2)
D-: U5.AD4 (D-), USB1.A7 (Dn1), USB1.B7 (Dn2)
DC: FPC1.11, U5.K2 (P0.05/AIN3)
DCC: C2.1, C3.1, L2.1, U5.B5 (DEC4), U5.E24 (DEC6)
GDR: FPC1.2, Q1.1 (G), R4.2
GH: C27.1, D3.1 (C), FPC1.21
GL: C25.1, D1.2 (A), FPC1.23
GND: C1.1, C2.2, C3.2, C4.1, C5.1, C6.2, C7.2, C8.2, C9.2, C10.1, C11.1, C12.1, C13.2, C14.2, C15.2, C16.1, C17.1, C18.1, C19.1, C20.1, C21.1, C22.1, C23.1, C24.1, C25.2, C27.2, C28.1, C29.2, C30.1, C31.2, C32.2, C33.1, C34.2, C35.1, C36.2, C37.1, C38.1, C39.2, C40.2, C41.1, C42.2, C43.2, C44.1, C46.1, D2.1 (C), FPC1.8, FPC1.17, J1.1, J2.1, JP1.2 (B), L7.2, R3.2, R4.1, R11.2, R12.2, SW1.2, SW2.2, SW3.2, U1.5 (GND), U1.11 (THERMAL), U2.6 (GNDIO), U2.7 (GND), U3.A5 (CSB), U3.C1 (SDO), U3.C5 (GND), U3.E1 (GND), U3.E3 (GND), U4.5 (VSS), U5.0 (EP), U5.B7 (VSS), U5.F23 (VSS_PA), U6.1 (CTG), U6.4 (GND), U6.6 (QSTRT), U6.9 (EP), U7.2 (L/R), U7.3 (GND), U8.4 (GND), U8.9 (EP), USB1.13 (EH), USB1.14 (EH), USB1.A1B12 (GND), USB1.B1A12 (GND), X2.2 (GND), X2.4 (GND)
MAX_ALRT: U5.P23 (P1.07), U6.5 (~ALRT)
MIC_CLK: U5.AD22 (P1.00/TRACEDATA0), U7.4 (CLK)
MIC_DAT: U5.Y23 (P1.01), U7.1 (DATA)
MOSI: FPC1.14, U5.A12 (P0.02/AIN0)
NFC: U5.J24 (P0.10/NFC2), U5.L24 (P0.09/NFC1)
unnamed: AE1.1 (ANT), L8.2
unnamed: C15.1, L4.2, L5.1
unnamed: C16.2, FPC1.5
unnamed: C21.2, FPC1.18
unnamed: C22.2, FPC1.20
unnamed: C23.2, FPC1.22
unnamed: C24.2, FPC1.24
unnamed: C45.1, L5.2
unnamed: C45.2, L7.1, L8.1
unnamed: C26.2, D1.1 (C), D2.2 (A)
unnamed: C26.1, D3.2 (A), L6.2, Q1.3 (D)
unnamed: L1.1, L2.2
unnamed: L1.2, U5.B3 (DCC)
unnamed: L3.1, U5.AB2 (DCCH)
unnamed: C1.2, U5.C1 (DEC1)
unnamed: C4.2, U5.D23 (DEC3)
unnamed: C5.2, U5.N24 (DEC5)
unnamed: C8.1, U5.AC5 (DECUSB)
unnamed: C43.1, R6.1, U7.5 (AVDD)
unnamed: R11.1, USB1.A5 (CC1)
unnamed: R12.1, USB1.B5 (CC2)
RES: FPC1.10, R1.1, U5.L1 (P0.06)
RESE: FPC1.3, Q1.2 (S), R3.1
RST: C33.2, J2.3, U5.AC13 (P0.18/nRESET)
RV_INT: U4.2 (~INT), U5.U24 (P1.04)
RV_SCL: R7.1, U4.3 (SCL), U5.W24 (P1.02)
RV_SDA: R13.2, U4.4 (SDA), U5.V23 (P1.03)
SCK: FPC1.13, U5.B13 (P0.03/AIN1)
SWCLK: J2.5, U5.AA24 (SWDCLK)
SWDIO: J2.4, U5.AC24 (SWDIO)
SYS: C9.1, C34.1, C38.2, U1.1 (SYS), U4.6 (VBACKUP), U4.7 (VDD), U5.Y2 (VDDH)
TS: J1.2, JP1.1 (A), U1.6 (TS/MR)
VBUS: C7.1, C36.1, U1.10 (IN), U5.AD2 (VBUS), USB1.A4B9 (VBUS), USB1.B4A9 (VBUS)
VDD: C6.1, C10.2, C11.2, C12.2, C13.1, C17.2, C18.2, C19.2, C20.2, C28.2, C39.1, C40.1, C41.2, C42.1, C44.2, C46.2, FPC1.15, FPC1.16, J2.2, L3.2, L6.1, R1.2, R2.2, R5.2, R6.2, R7.2, R8.1, R9.2, R10.1, R13.1, R14.2, R15.1, U2.5 (VDDIO), U2.8 (VDD), U3.A1 (PS), U3.B2 (VDDIO), U3.E5 (VDD), U5.A22 (VDD), U5.AD14 (VDD), U5.AD23 (VDD), U5.B1 (VDD), U5.W1 (VDD), U7.6 (DVDD), U8.8 (VCC)
W25_CLK: U5.AC21 (P0.25), U8.6 (CLK)
W25_CS: R9.1, U5.AD20 (P0.24), U8.1 (~CS)
W25_IO0: U5.B11 (P0.28/AIN4), U8.5 (DI(IO0))
W25_IO1: U5.A10 (P0.29/AIN5), U8.2 (DO(IO1))
W25_IO2: U5.B9 (P0.30/AIN6), U8.3 (WP#(IO2))
W25_IO3: U5.A8 (P0.31/AIN7), U8.7 (HOLD#orRESET#(IO3))
XC1: C31.1, U5.B24 (XC1), X2.1
XC2: C32.1, U5.A23 (XC2), X2.3
XL1: C29.1, U5.D2 (P0.00/XL1), X1.1
XL2: C30.2, U5.F2 (P0.01/XL2), X1.2

Notes on the sheet:
Crystal 2
Controls
Storage
RTC
Mic
Power stuff
Display
Magneto- meter
IMU
Sensors
MCU
GDEY0154D67
Fuel Gauge
Battery Charger
Crystal 1
Antenna
USB-c
Debug

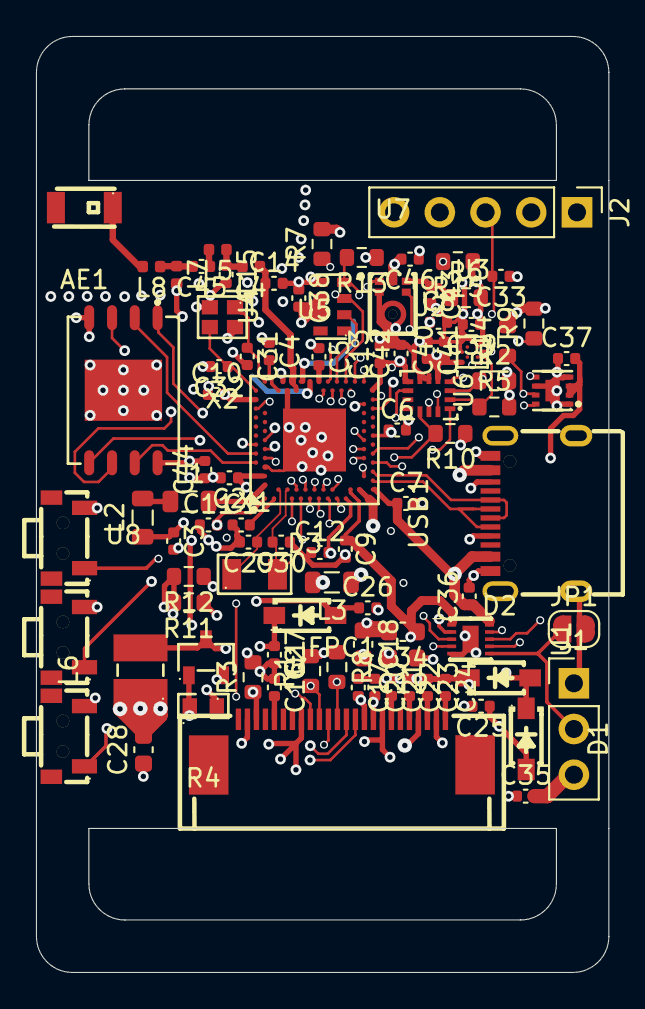
[picture p12: board Smart watch.kicad_pcb from above]

Board: 6 copper layers, 31.8 x 52.0 mm, 92 parts (0 on the bottom side), 77 nets.
