TomasD-git/Smart-watch/(commit log)

2026-09-03 added CAD files
    [Smart Watch source CAD.f3z]
2026-09-03 added PCB files
    [LCSC_BOM.xls, Smart watch NFC Coil.kicad_pcb, Smart watch NFC Coil.kicad_sch, Smart watch.kicad_pcb, Smart watch.kicad_sch, designators.csv, positions.csv]
2026-09-03 added production files
    [LCSC_BOM.xls, designators.csv, positions.csv]
